Dreamy-Z3r0/Autonomous-Wireless-Agrometeorology-Station/README.md

# Autonomous-Wireless-Agrometeorology-Station
