Dreamy-Z3r0/Autonomous-Wireless-Agrometeorology-Station/Station/Software/AutonomousWirelessAgrometeorologyStation/include/Macros_and_Defines.h

#ifndef _MACROS_AND_DEFINES_H_
#define _MACROS_AND_DEFINES_H_


/****************************
 *** Basic communications ***
 ****************************/
// UART
// #define DEBUGGING_OVER_SERIAL   // Un-comment/Comment to enable/disable printing over Serial for debugging
// #define SERIAL_MONITOR_OUTPUT   // Un-comment/Comment to enable/disable printing messages on Serial Monitor
// #define RASPBERRY_PI_LOGGING    // Un-comment/Comment to enable/disable data logging in another controller/processor in tests

#define BAUD_RATE 9600          // Define baud rate for UART communication

/***********************************************
 *** SX1278: Long-Range (LoRa) Communication ***
 ***********************************************/
#define LoRa_SPI_MOSI_Pin PB15
#define LoRa_SPI_MISO_Pin PB14
#define LoRa_SPI_SCLK_Pin PB13

#define LoRa_Module_SPI_Clock LORA_DEFAULT_SPI_FREQUENCY

#define LoRa_NCSS_Pin PB12
#define LoRa_RST_Pin  PA8
#define LoRa_IRQ_Pin  PA11

#define LoRa_Project_Frequency (long)433E6

#define LoRa_Project_Spreading_Factor 12
#define LoRa_Project_Signal_Bandwidth 500E3
#define LoRa_Project_Coding_Rate_4_Denominator 8
#define LoRa_Project_Sync_Word 0x92
#define LoRa_Project_Transmission_Power 17


/********************************
 *** SD card's requirement(s) ***
 ********************************/
#define TF_SPI1_MOSI_Pin PA7
#define TF_SPI1_MISO_Pin PA6
#define TF_SPI1_SCLK_Pin PA5
#define TF_SPI1_NCSS_Pin PA4


/*******************************
 *** DS32331 Real-time Clock ***
 *******************************/
// #define Alarm_InputPin PA15   -> must be directly declared in RTC.cpp


/*******************************************************************
 *** BME280: Temperature - Humidity - Barometric pressure sensor ***
 *******************************************************************/
// #define BME_CS_Pin PA4    // SSEL pin for BME280
#define BME280_I2C_ADDR 0x76


/***********************************
 *** DS18B20: Temperature sensor ***
 ***********************************/
#define OneWireBus PB3    // Digital pin as the one-wire bus


/******************
 *** Rain gauge ***
 ******************/
#define RainGauge_InputPin PA1


/*****************
 *** Wind vane ***
 *****************/
// #define WindVane_InputPin PB1     -> ADC; no need to be declared


/******************
 *** Anemometer ***
 ******************/
#define Anemometer_InputPin PA3

#endif
