Dreamy-Z3r0/Autonomous-Wireless-Agrometeorology-Station/(commit log)

2023-10-22 Initiate project + copy final files from thesis
    [Gateway-Hardware.kicad_pcb, Gateway-Hardware.kicad_sch, Station-Hardware-ver-01.kicad_pcb, Station-Hardware-ver-01.kicad_sch]
2023-10-22 station pcb: update resistors from tht to smt
    [Station-Hardware-ver-01.kicad_sch]
2023-10-22 station pcb: update ceramic capacitors to smd
    [Station-Hardware-ver-01.kicad_sch]
2023-10-22 station pcb: update electrolytic capacitors to smd
    [Station-Hardware-ver-01.kicad_sch]
2023-10-22 station pcb: change LM317 footprint
    [Station-Hardware-ver-01.kicad_sch]
2023-10-24 pcb design for the station
    [Station-Hardware-ver-01-B_Cu.gbr, Station-Hardware-ver-01-B_Fab.gbr, Station-Hardware-ver-01-B_Mask.gbr, Station-Hardware-ver-01-B_Silkscreen.gbr, Station-Hardware-ver-01-Edge_Cuts.gbr, Station-Hardware-ver-01-F_Cu.gbr, Station-Hardware-ver-01-F_Fab.gbr, Station-Hardware-ver-01-F_Mask.gbr]
2023-10-24 Update PCB rules
    [Station-Hardware-ver-01-B_Cu.gbr, Station-Hardware-ver-01-B_Fab.gbr, Station-Hardware-ver-01-B_Mask.gbr, Station-Hardware-ver-01-B_Silkscreen.gbr, Station-Hardware-ver-01-Edge_Cuts.gbr, Station-Hardware-ver-01-F_Cu.gbr, Station-Hardware-ver-01-F_Fab.gbr, Station-Hardware-ver-01-F_Mask.gbr]
2023-10-25 Update PCB to meet requirements by Kha Thành
    [Station-Hardware-ver-01-B_Cu.gbr, Station-Hardware-ver-01-B_Fab.gbr, Station-Hardware-ver-01-B_Mask.gbr, Station-Hardware-ver-01-B_Silkscreen.gbr, Station-Hardware-ver-01-Edge_Cuts.gbr, Station-Hardware-ver-01-F_Cu.gbr, Station-Hardware-ver-01-F_Fab.gbr, Station-Hardware-ver-01-F_Mask.gbr]
